Exequiel25/Digital-Wattmeter/Proteus/DWattmeter_Voltage_Schematic.png

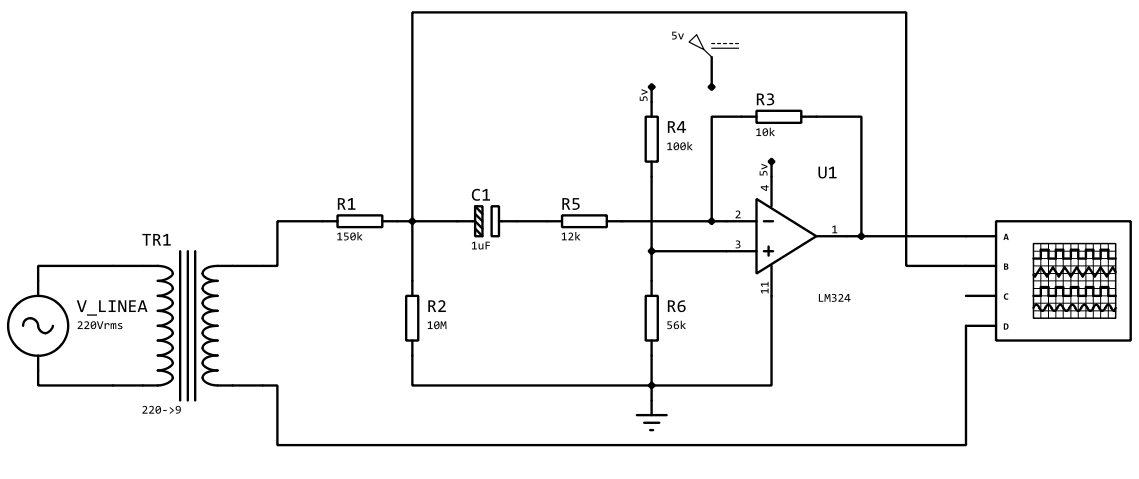
Proteus/DWattmeter_Voltage_Schematic.png
