Exequiel25/Digital-Wattmeter/(list of files, drawings)

Other design files:
Proteus/DWattmeter_Current_Schematic.pdsprj
Proteus/DWattmeter_Schematic.pdsprj
Proteus/DWattmeter_Voltage_Schematic.pdsprj
