Exequiel25/Digital-Wattmeter/Code_DWattmeter/Code_DWattmeter.ioc

Mcu.UserName=STM32F103C8Tx
PA13.Signal=SYS_JTMS-SWDIO
PA14.Signal=SYS_JTCK-SWCLK
PA15.GPIO_Label=MOD_MENU
PA15.Signal=GPXTI15
PA4.Signal=ADCx_IN4
PA8.GPIO_Label=SD_CS
PA8.Signal=GPIO_Output
PB1.Signal=ADCx_IN9
PB10.GPIO_Label=WRITE_SD
PB10.Signal=GPXTI10
PB12.GPIO_Label=ALERT_LED
PB12.Signal=GPIO_Output
PB13.Signal=SPI2_SCK
PB14.Signal=SPI2_MISO
PB15.Signal=SPI2_MOSI
PB6.Signal=I2C1_SCL
PB7.Signal=I2C1_SDA
PC13-TAMPER-RTC.GPIO_Label=BUILDIN_LED
PC13-TAMPER-RTC.Signal=GPIO_Output
PC14-OSC32_IN.Signal=RCC_OSC32_IN
PC15-OSC32_OUT.Signal=RCC_OSC32_OUT
PD0-OSC_IN.Signal=RCC_OSC_IN
PD1-OSC_OUT.Signal=RCC_OSC_OUT
