Exequiel25/Digital-Wattmeter/(commit log)

2022-10-31 Starting project
    [Schematic_DWattmeter [20221031, 13-33-47].pdsprj, Schematic_DWattmeter [20221031, 13-33-53].pdsprj, Schematic_DWattmeter.pdsprj]
2022-11-03 LCD working, ADC almost
    [Schematic_DWattmeter [20221031, 13-33-47].pdsprj, Schematic_DWattmeter [20221031, 13-33-53].pdsprj, Schematic_DWattmeter.pdsprj]
2022-11-21 RTC, SD Card, Readings Completed - Correct calculations
    [Code_DWattmeter.ioc, fatfs_sd.h, lcd_i2c.c, lcd_i2c.h, main.c, main.h]
2022-11-30 End of Project
    [DWattmeter_Schematic.pdsprj]
